walteraguirre/QCM/Circuitos - PCBs/Circuitos - PCBs/oscilador/osc_imp_fisica.pdf

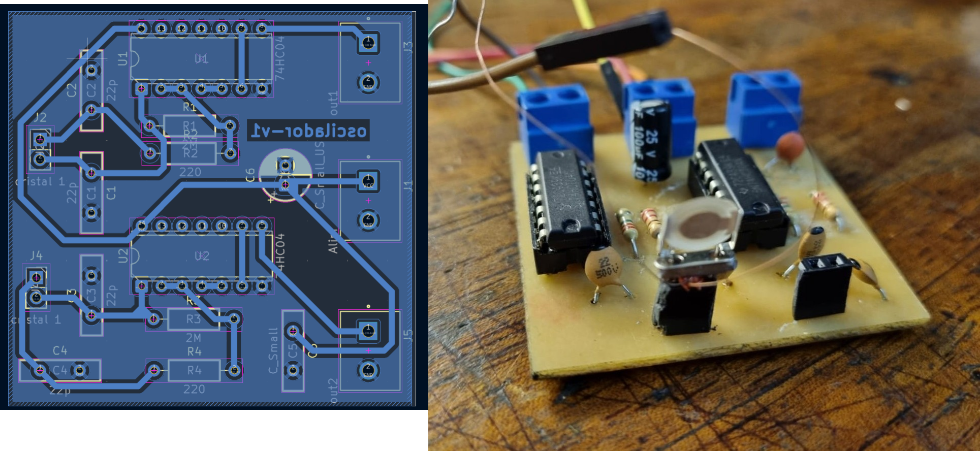
[picture p3: page 1]
