walteraguirre/QCM/Circuitos - PCBs/Circuitos - PCBs/oscilador_v2/pcb_abajo.png

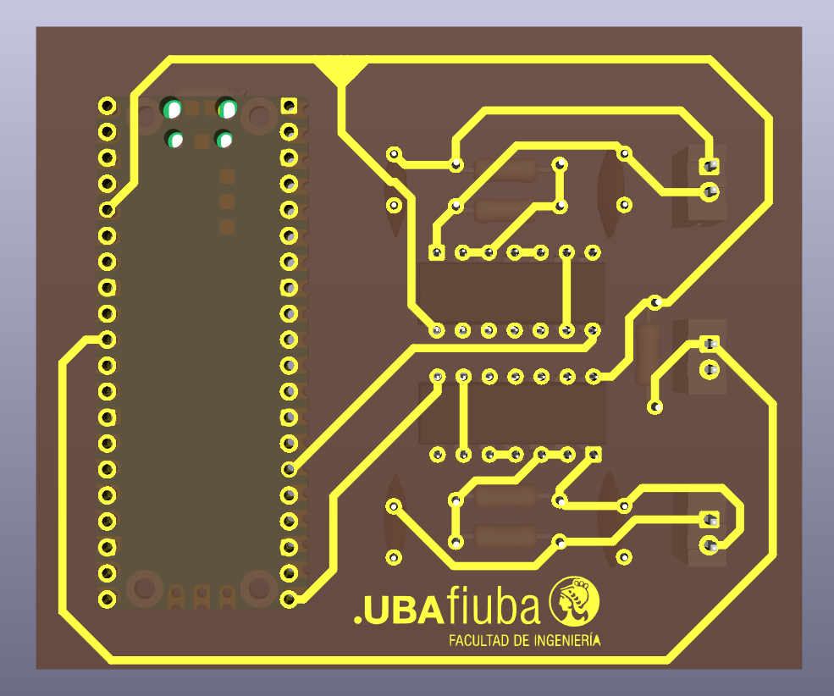
Circuitos - PCBs/Circuitos - PCBs/oscilador_v2/pcb_abajo.png
