walteraguirre/QCM/Circuitos - PCBs/Circuitos - PCBs/oscilador_v2/pcb_frente.png

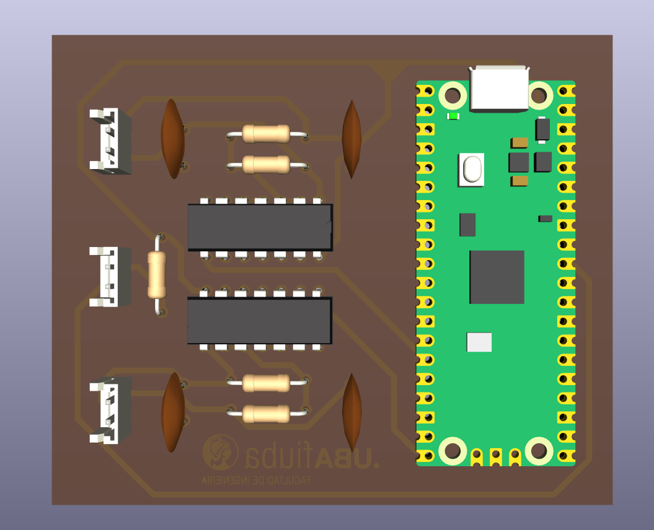
Circuitos - PCBs/Circuitos - PCBs/oscilador_v2/pcb_frente.png
