walteraguirre/QCM/error.png

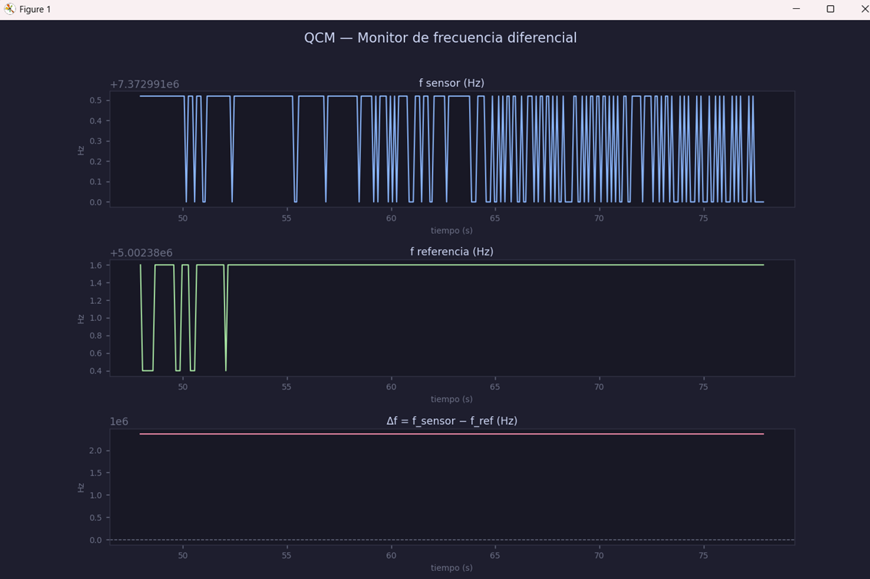
error.png
