walteraguirre/QCM/Gráficos/Oscilador/esquematico_oscilador_lt.png

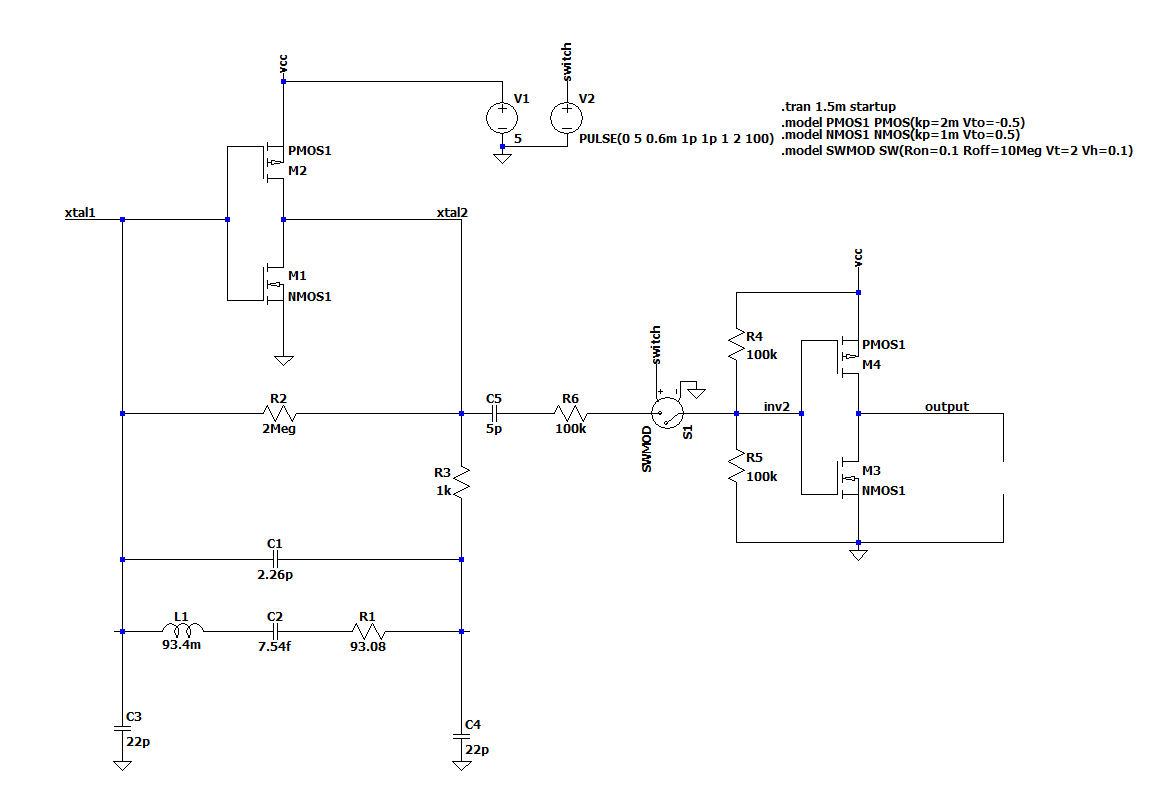
Gráficos/Oscilador/esquematico_oscilador_lt.png
