walteraguirre/QCM/Gráficos/Oscilador/medición_con_arduino_nano.jpeg

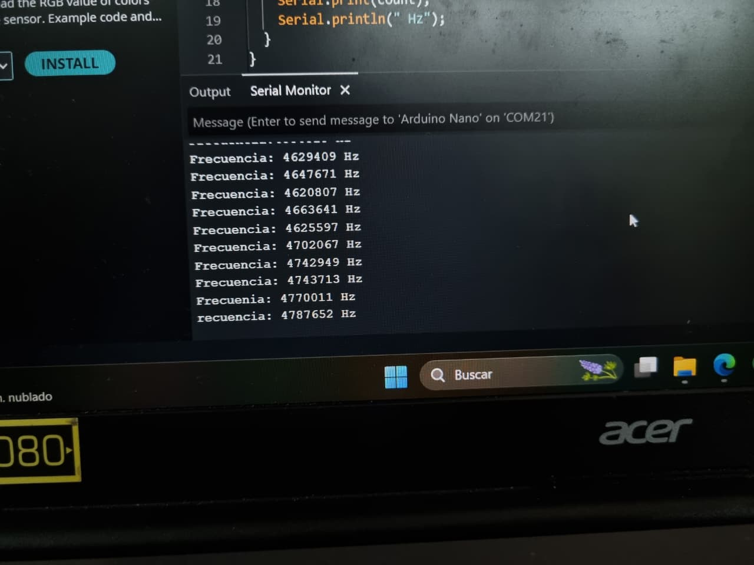
Gráficos/Oscilador/medición_con_arduino_nano.jpeg
