walteraguirre/QCM/Gráficos/Oscilador/osc_a_la_salida_del_buffer.jpeg

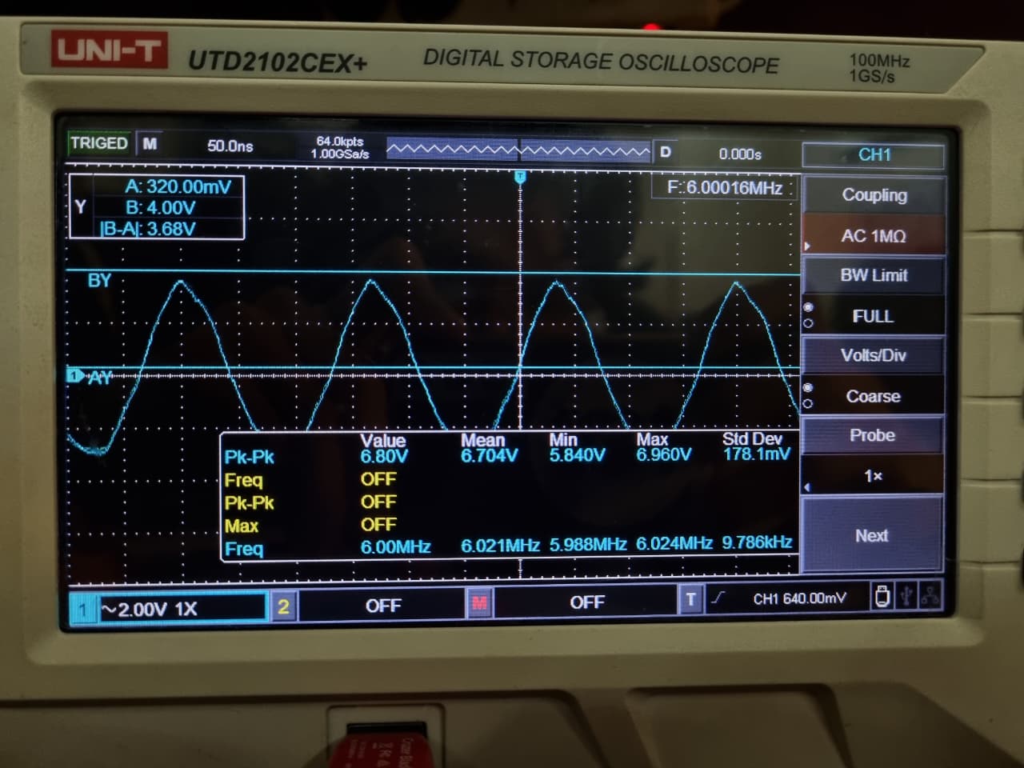
Gráficos/Oscilador/osc_a_la_salida_del_buffer.jpeg
