walteraguirre/QCM/Gráficos/Oscilador/osc_salida_buffer.jpeg

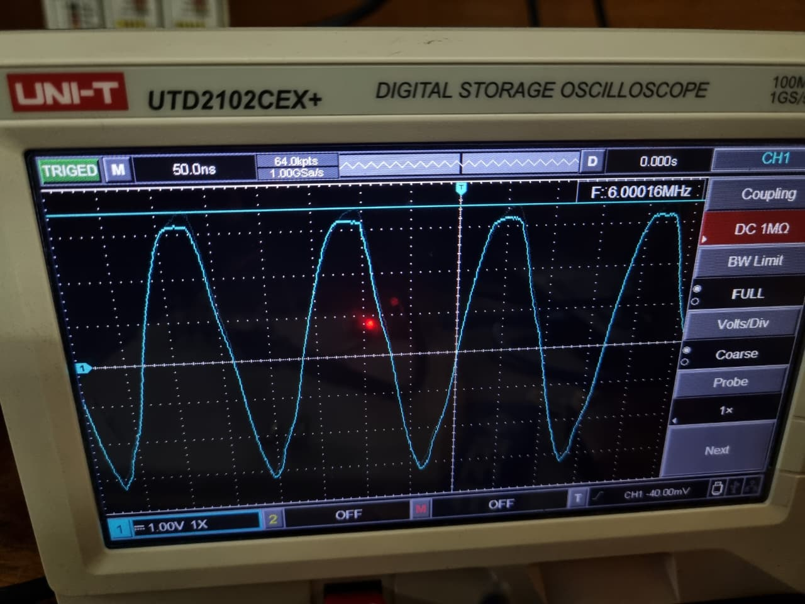
Gráficos/Oscilador/osc_salida_buffer.jpeg
