walteraguirre/QCM/Gráficos/Oscilador/osc_salida_cristal.jpeg

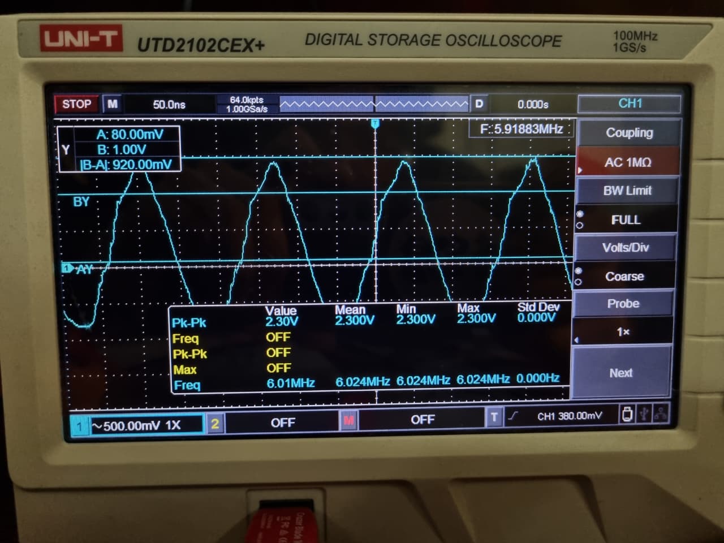
Gráficos/Oscilador/osc_salida_cristal.jpeg
