walteraguirre/QCM/Gráficos/Oscilador/osc_sin_buffer.png

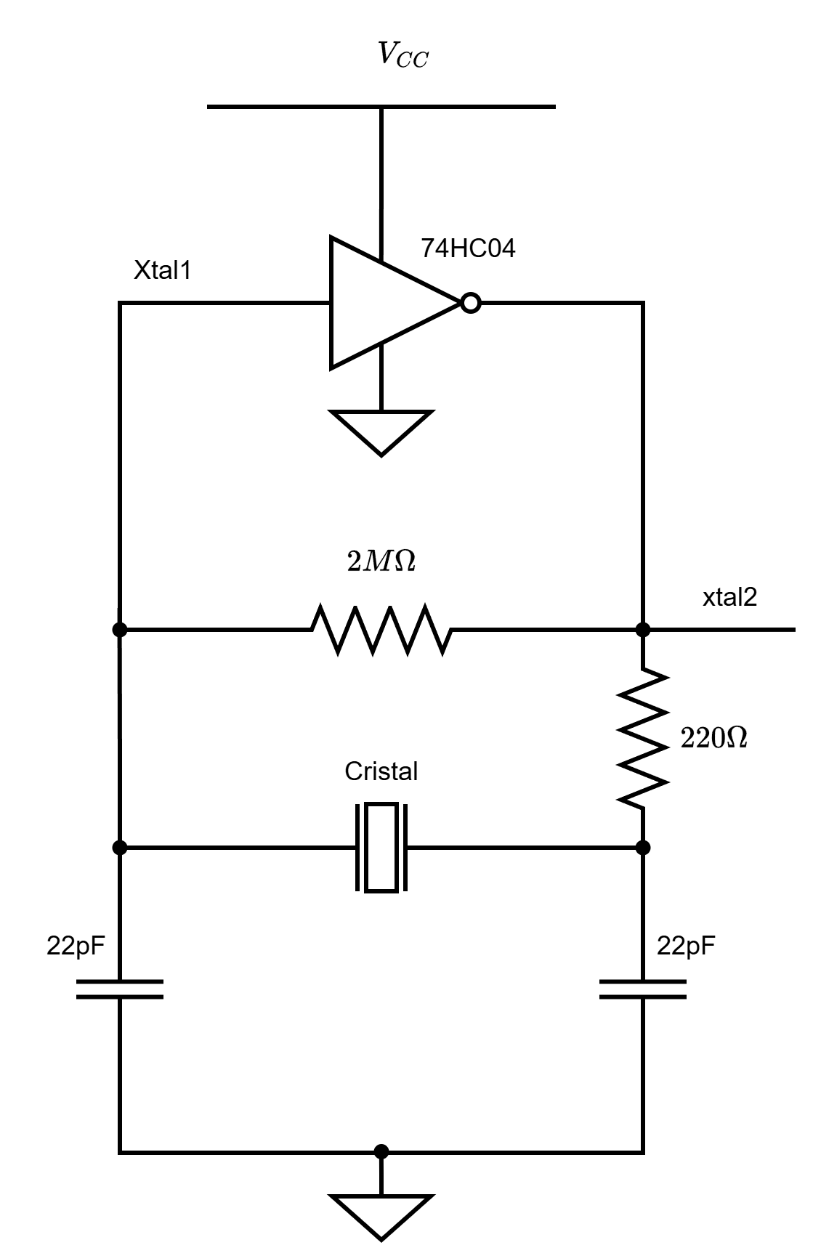
Gráficos/Oscilador/osc_sin_buffer.png
