walteraguirre/QCM/Gráficos/Oscilador/WhatsApp Image 2026-05-27 at 22.09.08.jpeg

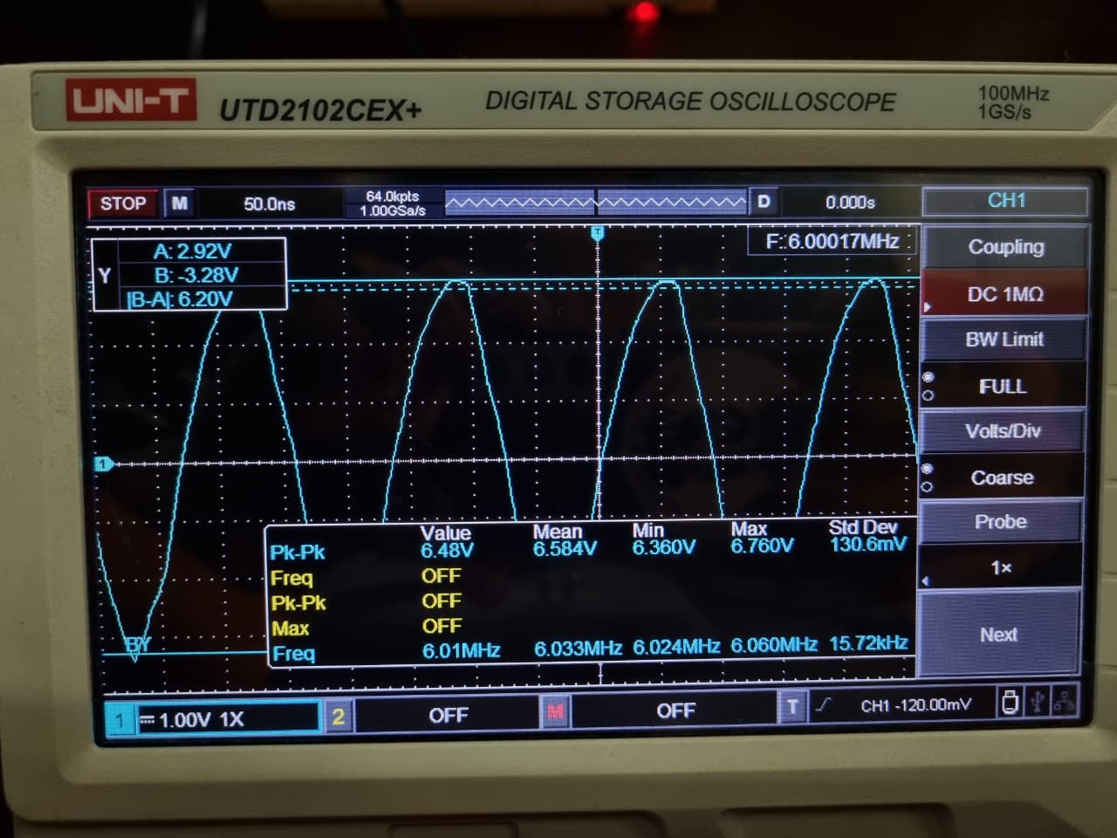
Gráficos/Oscilador/WhatsApp Image 2026-05-27 at 22.09.08.jpeg
