walteraguirre/QCM/pcb_osc.png

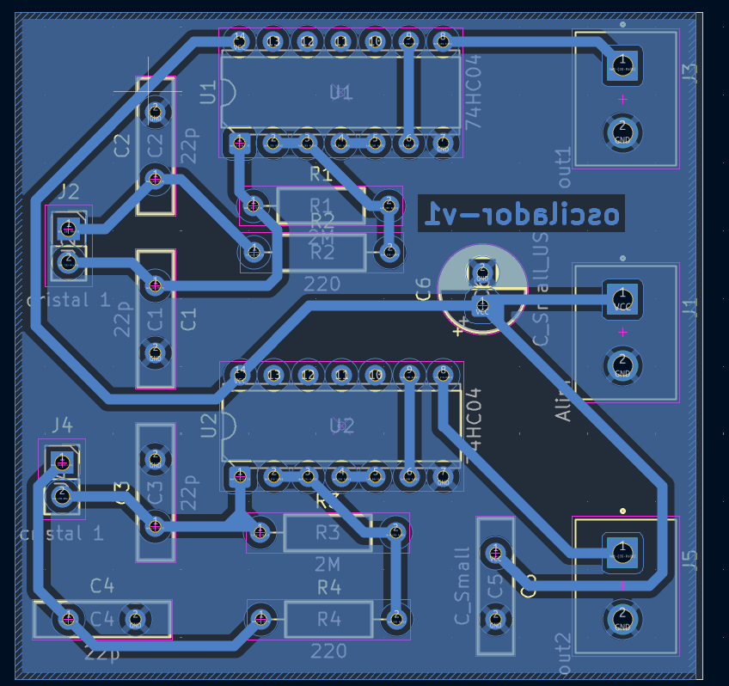
pcb_osc.png
