walteraguirre/QCM/Códigos/PC/Visualizador v1/prueba_termistor.csv

# QCM — 2026-10-13 11:40:28
# f0_real=7146438.762 Hz
# material_density=2700.0 kg/m3
# mode=single
timestamp_s | f_sensor_hz | f_ref_hz | delta_f_hz | espesor_nm | temp_c
31.0 | 7146437.600 | 7146438.762 | -1.162 | 0.037220 | 23.15
32.0 | 7146438.000 | 7146438.762 | -0.762 | 0.024408 | 21.32
33.0 | 7146440.000 | 7146438.762 | 1.238 | -0.039655 | 21.64
34.0 | 7146438.000 | 7146438.762 | -0.762 | 0.024408 | 21.07
35.0 | 7146438.400 | 7146438.762 | -0.362 | 0.011595 | 20.75
36.0 | 7146438.400 | 7146438.762 | -0.362 | 0.011595 | 20.84
37.0 | 7146436.000 | 7146438.762 | -2.762 | 0.088471 | 21.68
38.0 | 7146433.000 | 7146438.762 | -5.762 | 0.184565 | 20.93
39.0 | 7146431.000 | 7146438.762 | -7.762 | 0.248628 | 21.08
40.0 | 7146429.000 | 7146438.762 | -9.762 | 0.312691 | 21.34
41.0 | 7146426.000 | 7146438.762 | -12.762 | 0.408785 | 21.51
42.0 | 7146423.840 | 7146438.762 | -14.922 | 0.477973 | 20.80
43.0 | 7146422.000 | 7146438.762 | -16.762 | 0.536910 | 23.19
44.0 | 7146421.000 | 7146438.762 | -17.762 | 0.568942 | 21.73
45.0 | 7146420.000 | 7146438.762 | -18.762 | 0.600973 | 21.62
46.0 | 7146420.160 | 7146438.762 | -18.602 | 0.595848 | 20.93
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
