walteraguirre/QCM/Gráficos/Experimento con alcohol/mediciones/estabilidad_1.csv

# QCM — 2026-09-07 16:26:28
# f0_real=7149134.187 Hz
# material_density=2700.0 kg/m3
# mode=single
timestamp_s | f_sensor_hz | f_ref_hz | delta_f_hz | espesor_nm
31.0 | 7149133.600 | 7149134.187 | -0.587 | 0.018778
32.0 | 7149133.600 | 7149134.187 | -0.587 | 0.018778
33.0 | 7149133.600 | 7149134.187 | -0.587 | 0.018778
34.0 | 7149133.600 | 7149134.187 | -0.587 | 0.018778
35.0 | 7149133.600 | 7149134.187 | -0.587 | 0.018778
36.0 | 7149133.600 | 7149134.187 | -0.587 | 0.018778
37.0 | 7149133.000 | 7149134.187 | -1.187 | 0.037982
38.0 | 7149133.000 | 7149134.187 | -1.187 | 0.037982
39.0 | 7149133.000 | 7149134.187 | -1.187 | 0.037982
40.0 | 7149133.000 | 7149134.187 | -1.187 | 0.037982
41.0 | 7149133.000 | 7149134.187 | -1.187 | 0.037982
42.0 | 7149133.000 | 7149134.187 | -1.187 | 0.037982
43.0 | 7149133.000 | 7149134.187 | -1.187 | 0.037982
44.0 | 7149133.000 | 7149134.187 | -1.187 | 0.037982
45.0 | 7149133.000 | 7149134.187 | -1.187 | 0.037982
46.0 | 7149133.000 | 7149134.187 | -1.187 | 0.037982
47.0 | 7149133.000 | 7149134.187 | -1.187 | 0.037982
48.0 | 7149133.000 | 7149134.187 | -1.187 | 0.037982
49.0 | 7149133.000 | 7149134.187 | -1.187 | 0.037982
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
