walteraguirre/QCM/Gráficos/Experimento con alcohol/mediciones/estabilidad_30.csv

# QCM — 2026-09-08 17:28:47
# f0_real=7148857.376 Hz
# material_density=2700.0 kg/m3
# mode=single
timestamp_s | f_sensor_hz | f_ref_hz | delta_f_hz | espesor_nm
31.0 | 7148859.520 | 7148857.376 | 2.144 | -0.068629
32.0 | 7148859.000 | 7148857.376 | 1.624 | -0.051984
33.0 | 7148859.520 | 7148857.376 | 2.144 | -0.068629
34.0 | 7148860.000 | 7148857.376 | 2.624 | -0.083994
35.0 | 7148861.600 | 7148857.376 | 4.224 | -0.135209
36.0 | 7148863.000 | 7148857.376 | 5.624 | -0.180023
37.0 | 7148863.520 | 7148857.376 | 6.144 | -0.196668
38.0 | 7148863.520 | 7148857.376 | 6.144 | -0.196668
39.0 | 7148863.520 | 7148857.376 | 6.144 | -0.196668
40.0 | 7148863.520 | 7148857.376 | 6.144 | -0.196668
41.0 | 7148863.520 | 7148857.376 | 6.144 | -0.196668
42.0 | 7148863.000 | 7148857.376 | 5.624 | -0.180023
43.0 | 7148863.000 | 7148857.376 | 5.624 | -0.180023
44.0 | 7148862.400 | 7148857.376 | 5.024 | -0.160817
45.0 | 7148862.000 | 7148857.376 | 4.624 | -0.148013
46.0 | 7148862.400 | 7148857.376 | 5.024 | -0.160817
47.0 | 7148862.400 | 7148857.376 | 5.024 | -0.160817
48.0 | 7148863.000 | 7148857.376 | 5.624 | -0.180023
49.0 | 7148864.000 | 7148857.376 | 6.624 | -0.212032
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
