walteraguirre/QCM/Gráficos/Experimento con alcohol/mediciones/estabilidad_cristal_interno_rp.csv

# QCM — 2026-09-16 20:03:49
# f0_real=7150042.293 Hz
# material_density=2700.0 kg/m3
# mode=single
timestamp_s | f_sensor_hz | f_ref_hz | delta_f_hz | espesor_nm
193.0 | 7150042.000 | 7150042.293 | -0.293 | 0.009386
194.0 | 7150042.000 | 7150042.293 | -0.293 | 0.009386
195.0 | 7150042.000 | 7150042.293 | -0.293 | 0.009386
196.0 | 7150042.000 | 7150042.293 | -0.293 | 0.009386
197.0 | 7150042.000 | 7150042.293 | -0.293 | 0.009386
198.0 | 7150042.000 | 7150042.293 | -0.293 | 0.009386
199.0 | 7150042.000 | 7150042.293 | -0.293 | 0.009386
200.0 | 7150042.000 | 7150042.293 | -0.293 | 0.009386
201.0 | 7150042.000 | 7150042.293 | -0.293 | 0.009386
202.0 | 7150042.000 | 7150042.293 | -0.293 | 0.009386
203.0 | 7150042.000 | 7150042.293 | -0.293 | 0.009386
204.0 | 7150042.000 | 7150042.293 | -0.293 | 0.009386
205.0 | 7150042.000 | 7150042.293 | -0.293 | 0.009386
206.0 | 7150042.000 | 7150042.293 | -0.293 | 0.009386
207.0 | 7150042.000 | 7150042.293 | -0.293 | 0.009386
208.0 | 7150042.000 | 7150042.293 | -0.293 | 0.009386
209.0 | 7150042.000 | 7150042.293 | -0.293 | 0.009386
210.0 | 7150042.000 | 7150042.293 | -0.293 | 0.009386
211.0 | 7150042.000 | 7150042.293 | -0.293 | 0.009386
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
