walteraguirre/QCM/Gráficos/Experimento con alcohol/mediciones/etanol_00.csv

# QCM — 2026-09-03 19:00:15
# f0_real=7149073.600 Hz
# densidad_material=2700.0 kg/m3
# modo=single
timestamp_s | f_sensor_hz | f_ref_hz | delta_f_hz | espesor_nm
5.0 | 7149073.000 | 7149073.600 | -0.600 | 0.019205
6.0 | 7149072.000 | 7149073.600 | -1.600 | 0.051212
7.0 | 7149071.520 | 7149073.600 | -2.080 | 0.066576
8.0 | 7149069.000 | 7149073.600 | -4.600 | 0.147236
9.0 | 7149067.840 | 7149073.600 | -5.760 | 0.184365
10.0 | 7149068.000 | 7149073.600 | -5.600 | 0.179244
11.0 | 7149068.000 | 7149073.600 | -5.600 | 0.179244
12.0 | 7149066.000 | 7149073.600 | -7.600 | 0.243259
13.0 | 7149065.600 | 7149073.600 | -8.000 | 0.256062
14.0 | 7149065.000 | 7149073.600 | -8.600 | 0.275267
15.0 | 7149064.000 | 7149073.600 | -9.600 | 0.307275
16.0 | 7149065.600 | 7149073.600 | -8.000 | 0.256062
17.0 | 7149068.000 | 7149073.600 | -5.600 | 0.179244
18.0 | 7149066.000 | 7149073.600 | -7.600 | 0.243259
19.0 | 7149064.160 | 7149073.600 | -9.440 | 0.302154
20.0 | 7149064.160 | 7149073.600 | -9.440 | 0.302154
21.0 | 7149065.000 | 7149073.600 | -8.600 | 0.275267
22.0 | 7149066.000 | 7149073.600 | -7.600 | 0.243259
23.0 | 7149065.600 | 7149073.600 | -8.000 | 0.256062
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
