walteraguirre/QCM/Gráficos/Experimento con alcohol/mediciones/medicion_aislado_01.csv

# QCM — 2026-09-14 21:32:25
# f0_real=7152504.000 Hz
# material_density=2700.0 kg/m3
# mode=single
timestamp_s | f_sensor_hz | f_ref_hz | delta_f_hz | espesor_nm
31.0 | 7152504.160 | 7152504.000 | 0.160 | -0.005116
32.0 | 7152504.000 | 7152504.000 | 0.000 | -0.000000
33.0 | 7152504.160 | 7152504.000 | 0.160 | -0.005116
34.0 | 7152504.000 | 7152504.000 | 0.000 | -0.000000
35.0 | 7152504.000 | 7152504.000 | 0.000 | -0.000000
36.0 | 7152504.000 | 7152504.000 | 0.000 | -0.000000
37.0 | 7152504.000 | 7152504.000 | 0.000 | -0.000000
38.0 | 7152504.000 | 7152504.000 | 0.000 | -0.000000
39.0 | 7152504.000 | 7152504.000 | 0.000 | -0.000000
40.0 | 7152504.000 | 7152504.000 | 0.000 | -0.000000
41.0 | 7152504.000 | 7152504.000 | 0.000 | -0.000000
42.0 | 7152504.000 | 7152504.000 | 0.000 | -0.000000
43.0 | 7152504.160 | 7152504.000 | 0.160 | -0.005116
44.0 | 7152504.160 | 7152504.000 | 0.160 | -0.005116
45.0 | 7152504.000 | 7152504.000 | 0.000 | -0.000000
46.0 | 7152504.160 | 7152504.000 | 0.160 | -0.005116
47.0 | 7152504.000 | 7152504.000 | 0.000 | -0.000000
48.0 | 7152504.000 | 7152504.000 | 0.000 | -0.000000
49.0 | 7152504.160 | 7152504.000 | 0.160 | -0.005116
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
