walteraguirre/QCM/Códigos/Raspberry/reciprocal_frec_counter/resultados1.png

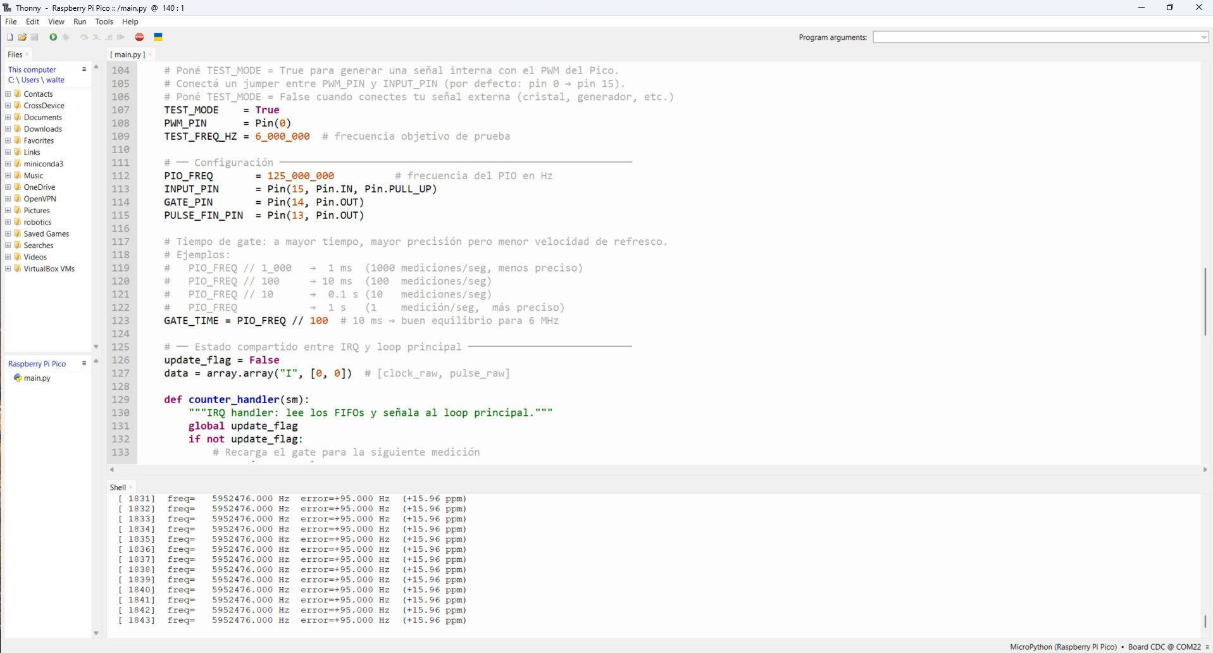
Códigos/Raspberry/reciprocal_frec_counter/resultados1.png
