walteraguirre/QCM/Códigos/Raspberry/reciprocal_frec_counter/resultados_gen_func.png

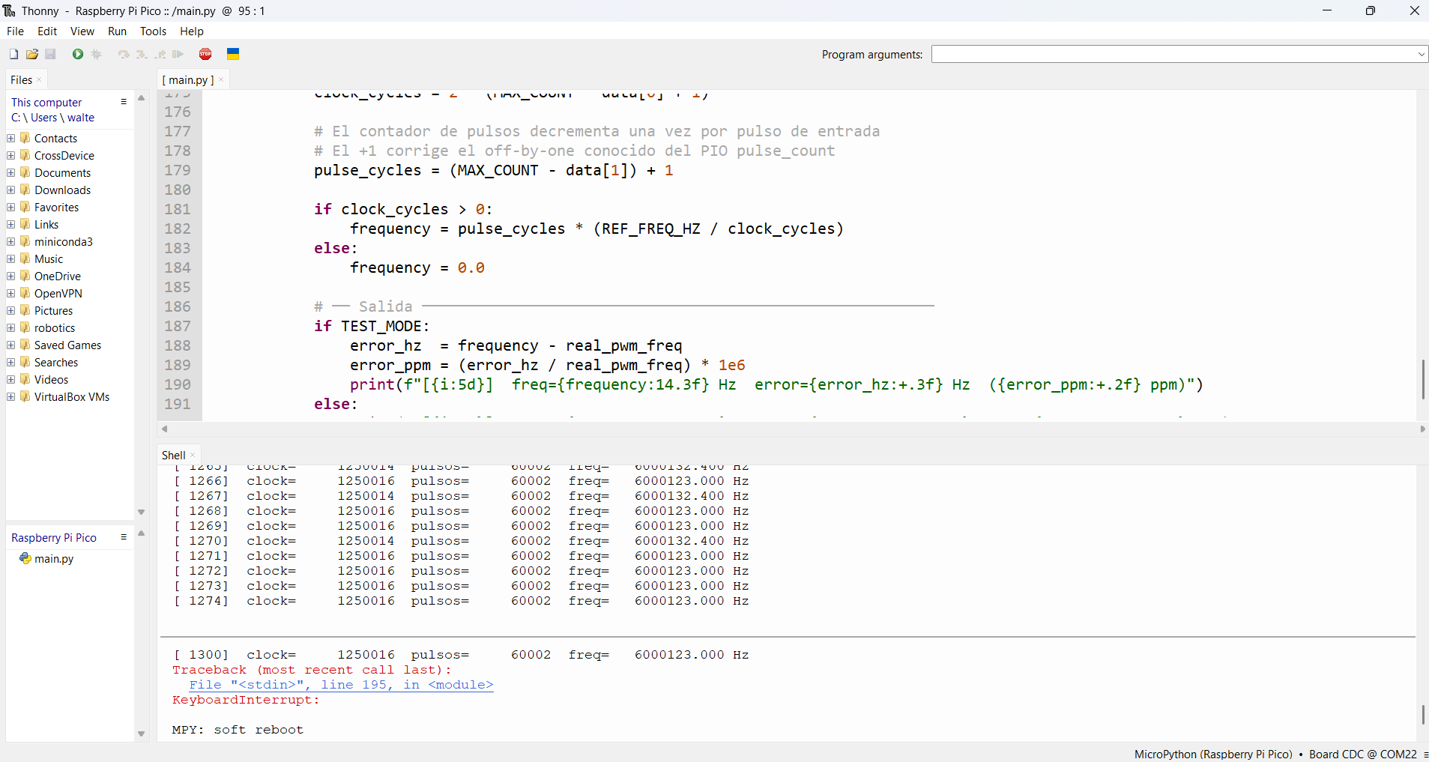
Códigos/Raspberry/reciprocal_frec_counter/resultados_gen_func.png
