walteraguirre/QCM/Gráficos/Experimento con alcohol/estado_estacionario.png

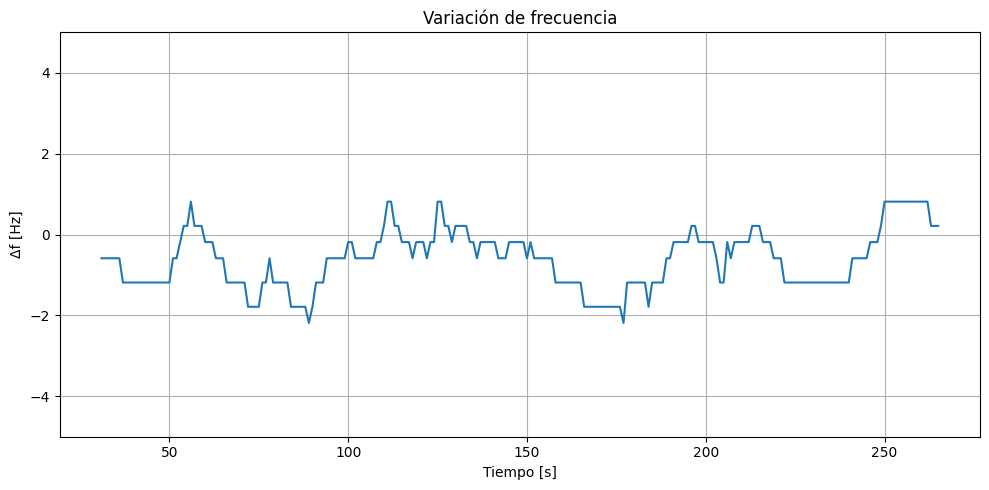
Gráficos/Experimento con alcohol/estado_estacionario.png
