walteraguirre/QCM/Circuitos - PCBs/Circuitos - PCBs/oscilador/esquemático.pdf

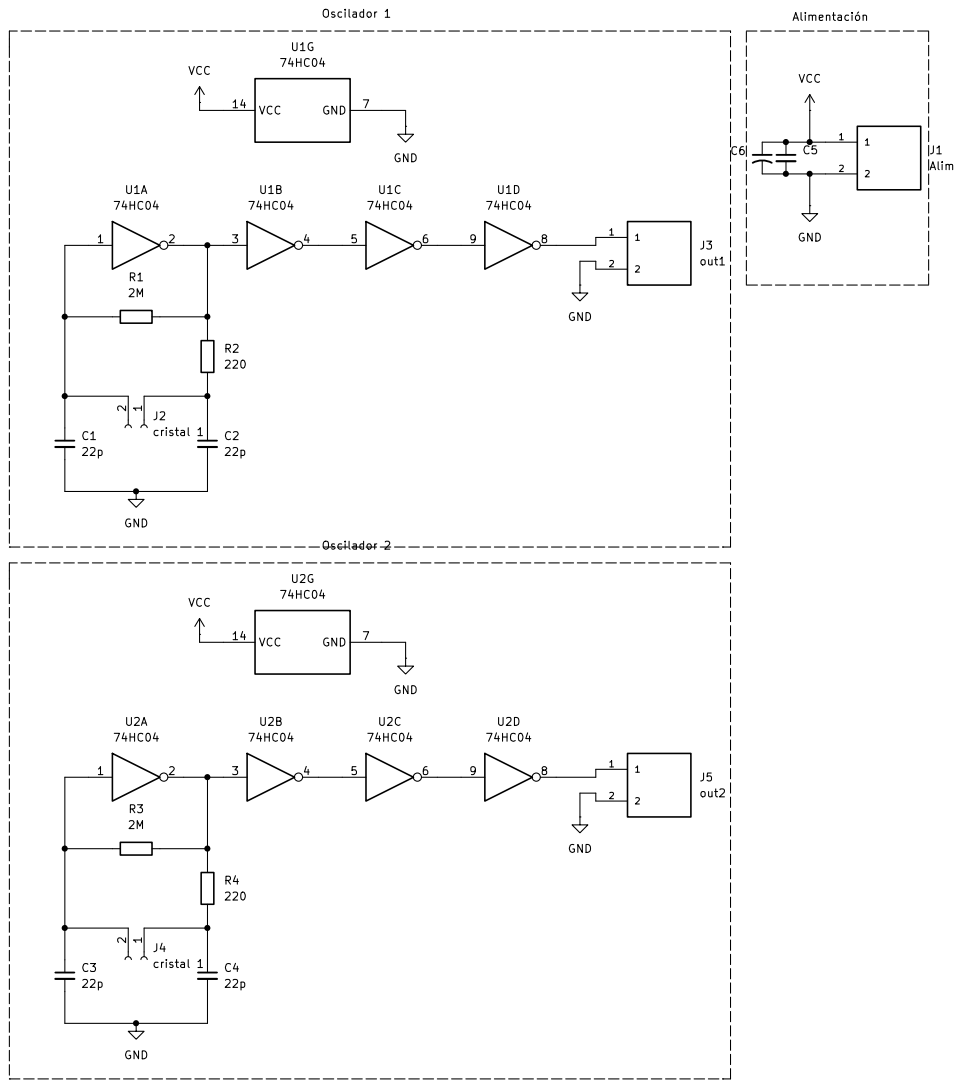
[picture p19: page 1]
