walteraguirre/QCM/Circuitos - PCBs/Circuitos - PCBs/oscilador_v2/esquemático.pdf

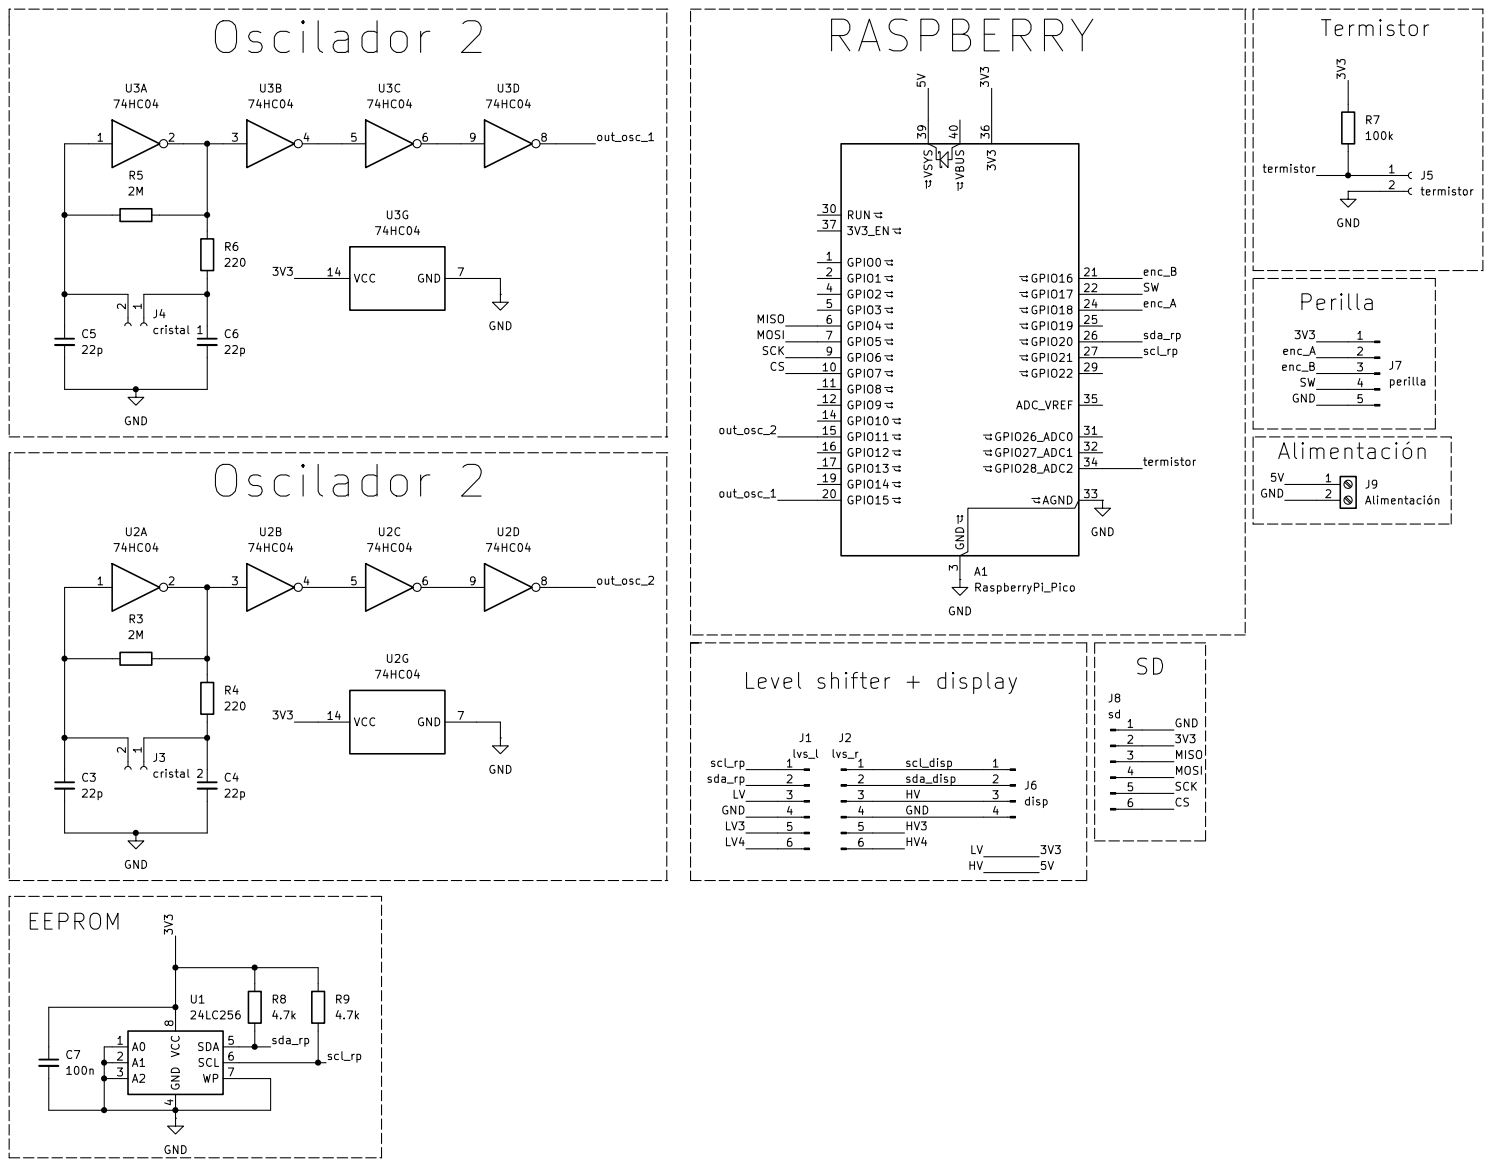
[picture p20: page 1]
