walteraguirre/QCM/Circuitos - PCBs/Circuitos - PCBs/oscilador_v2/pcb_qcm.pdf

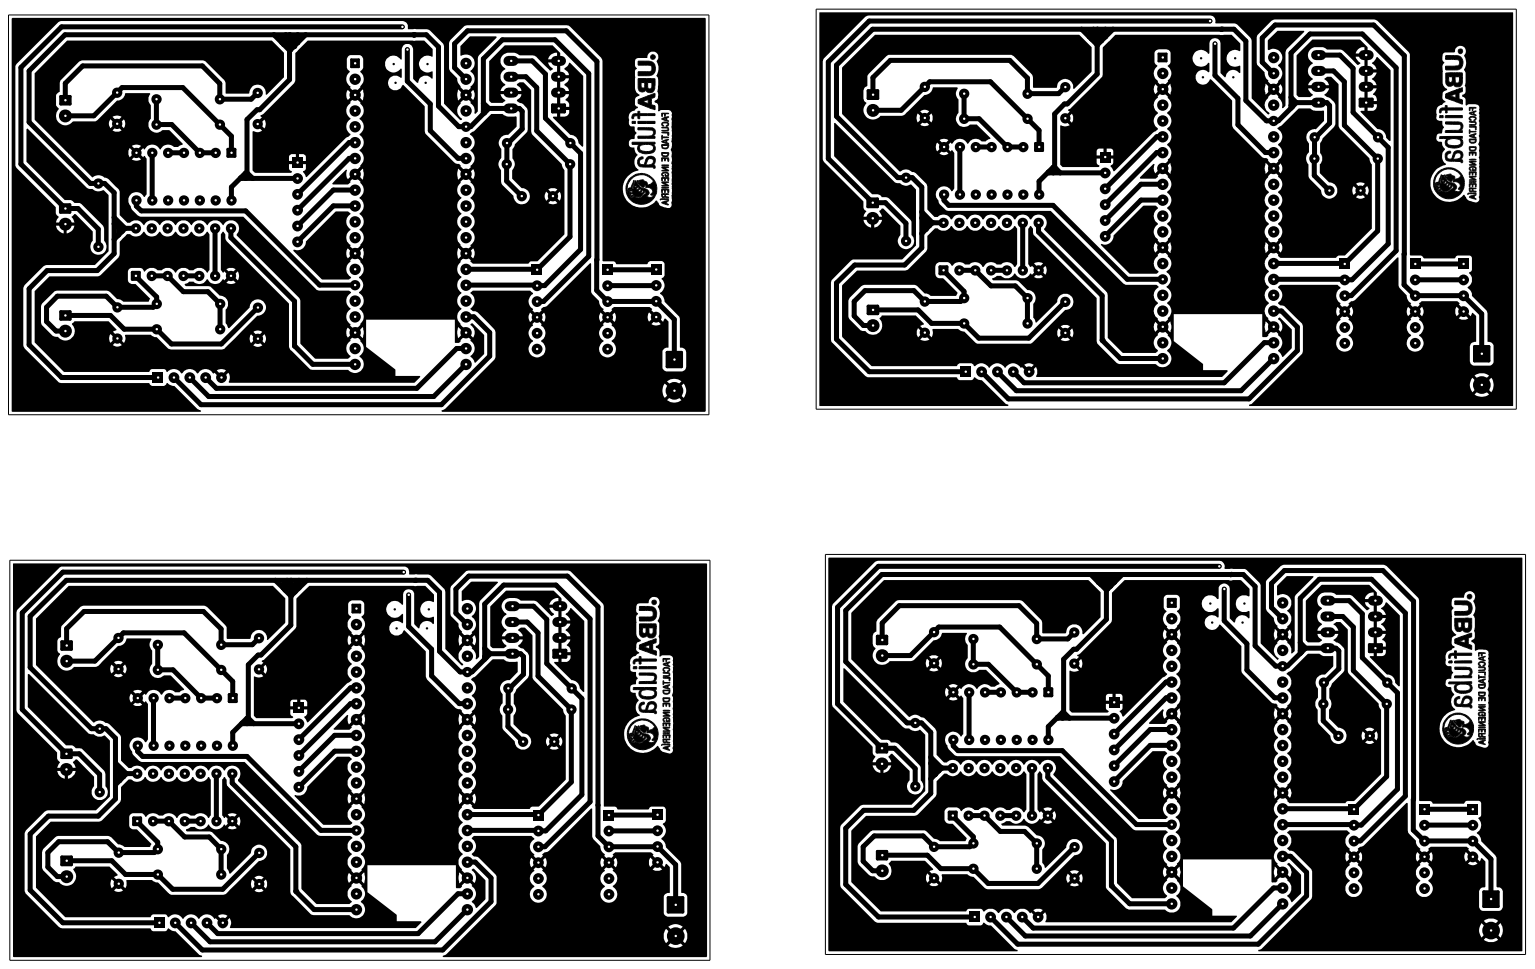
[picture p21: page 1]
