walteraguirre/QCM/Circuitos - PCBs/Circuitos - PCBs/oscilador/oscilador-B_Cu.pdf

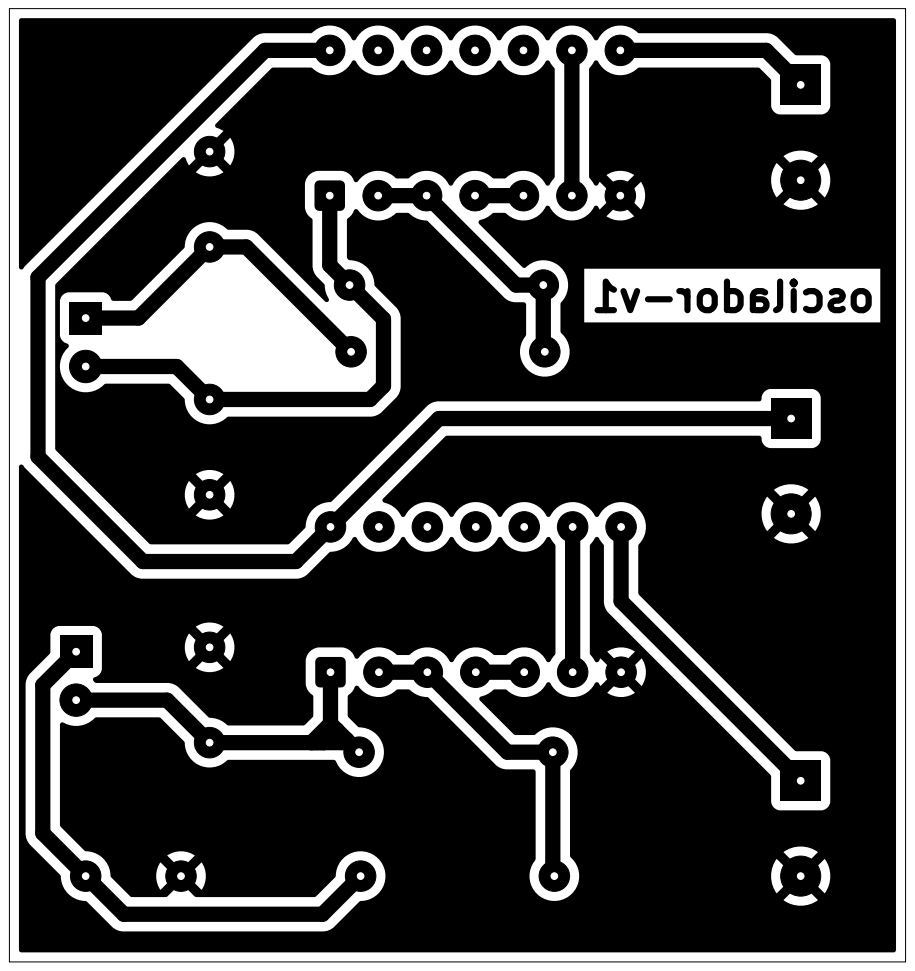
[picture p22: page 1]
