walteraguirre/QCM/Circuitos - PCBs/Circuitos - PCBs/oscilador/oscilador_pcb.pdf

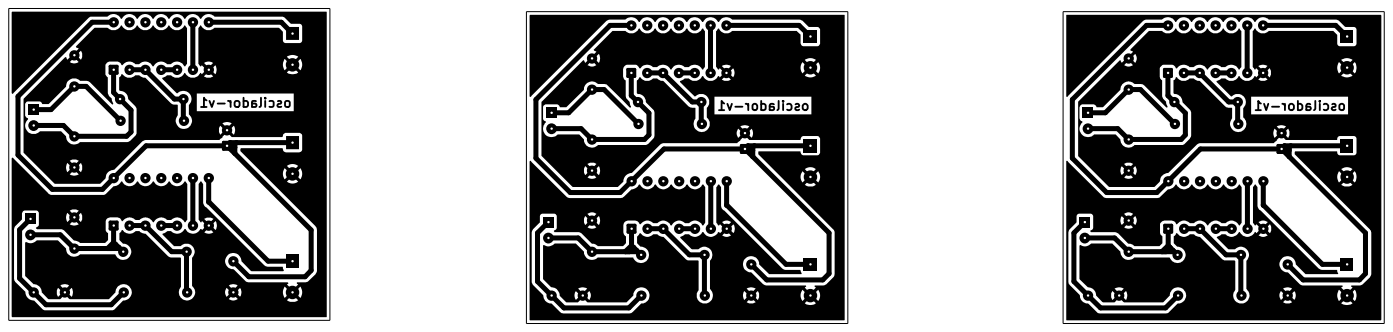
[picture p23: page 1]
