walteraguirre/QCM/Simulaciones/oscilador tesis wei/osc_hc04.asc

C1: cap; 2.26p
C2: cap; 7.54f
C3: cap; 22p
C4: cap; 22p
L1: ind; 93.4m; Rser=1m
R1: res; 93.08
R2: res; 470k
R3: res; 220
U1: inv; HCU04pck
U2: inv; HCU04pck
U3: inv; HCU04pck
U4: inv; HCU04pck
V1: voltage; 5
Named nets: 0, xtal1, xtal2, vcc, out
.tran 0 5m 0 10u startup
.include hc/hc_tnomi.cir
.include hc/dip.s
.options method=gear
.options reltol=0.01
