walteraguirre/QCM/Simulaciones/oscilador tesis wei/oscilador_unit1.asc

C1: cap; 2.26p
C2: cap; 7.54f
C3: cap; 22p
C4: cap; 22p
C5: cap; 5p
L1: ind; 93.4m; Rser=1m
M1: nmos; NMOS1
M2: pmos; PMOS1
M3: nmos; NMOS1
M4: pmos; PMOS1
R1: res; 93.08
R2: res; 2Meg
R3: res; 1k
R4: res; 100k
R5: res; 100k
R6: res; 100k
S1: sw; SWMOD
V1: voltage; 5
V2: voltage; PULSE(0 5 0.6m 1p 1p 1 2 100)
Named nets: 0, vcc, xtal1, xtal2, output, inv2, switch
.model PMOS1 PMOS(kp=2m Vto=-0.5)
.model NMOS1 NMOS(kp=1m Vto=0.5)
.tran 1.5m startup
.model SWMOD SW(Ron=0.1 Roff=10Meg Vt=2 Vh=0.1)
