walteraguirre/QCM/Circuitos - PCBs/Circuitos - PCBs/oscilador_v2/oscilador_v2.kicad_pcb

## KiCad design Circuitos - PCBs/Circuitos - PCBs/oscilador_v2/oscilador_v2.kicad_pcb (2026-10-15)

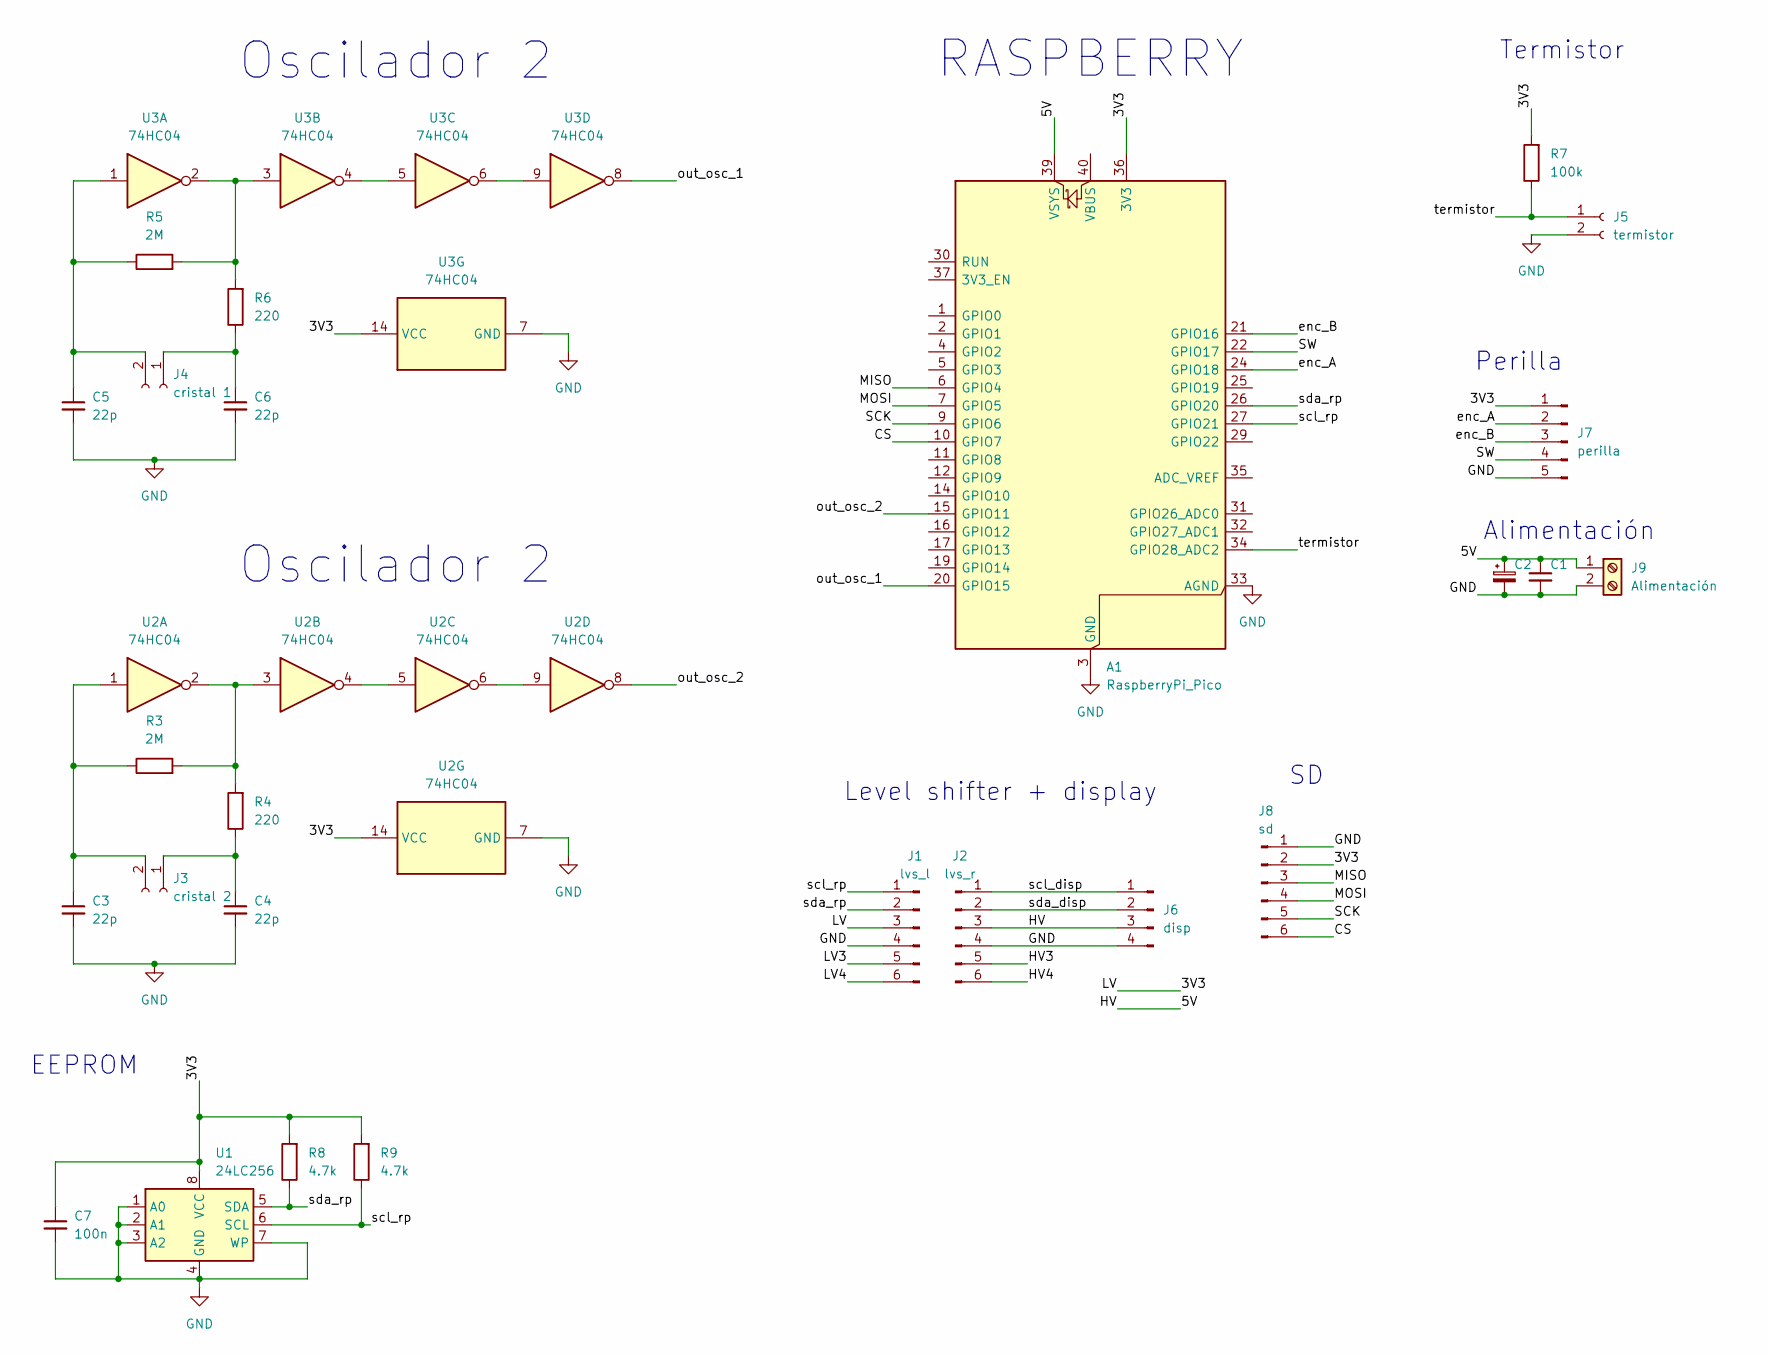
[picture p24: schematic oscilador_v2.kicad_sch]

Parts:
A1: RaspberryPi_Pico; RaspberryPi_Pico_Common_Unspecified
C1: C_Small; C_Disc_D10.0mm_W2.5mm_P5.00mm
C2: C_Polarized_Small; CP_Radial_D5.0mm_P2.50mm
C3, C4, C5, C6: 22p; C_Disc_D10.0mm_W2.5mm_P5.00mm
C7: 100n; C_Disc_D10.0mm_W2.5mm_P5.00mm
J1: lvs_l; PinSocket_1x06_P2.54mm_Vertical
J2: lvs_r; PinSocket_1x06_P2.54mm_Vertical
J3: cristal 2; JST_EH_B2B-EH-A_1x02_P2.50mm_Vertical
J4: cristal 1; JST_EH_B2B-EH-A_1x02_P2.50mm_Vertical
J5: termistor; JST_EH_B2B-EH-A_1x02_P2.50mm_Vertical
J6: disp; PinHeader_1x04_P2.54mm_Vertical
J7: perilla; PinHeader_1x05_P2.54mm_Vertical
J8: sd; PinSocket_1x06_P2.54mm_Vertical
J9: Alimentación; TerminalBlock_MaiXu_MX126-5.0-02P_1x02_P5.00mm
R3, R5: 2M; R_Axial_DIN0207_L6.3mm_D2.5mm_P10.16mm_Horizontal
R4, R6: 220; R_Axial_DIN0207_L6.3mm_D2.5mm_P10.16mm_Horizontal
R7: 100k; R_Axial_DIN0207_L6.3mm_D2.5mm_P10.16mm_Horizontal
R8, R9: 4.7k; R_Axial_DIN0207_L6.3mm_D2.5mm_P10.16mm_Horizontal
U1: 24LC256; DIP-8_W7.62mm_LongPads
U2, U3: 74HC04; DIP-14_W7.62mm

Connections:
/3V3: A1.36 (3V3), C7.1, J1.3, J7.1, J8.2, R7.2, R8.2, R9.2, U1.8 (VCC), U2.14 (VCC), U3.14 (VCC)
/5V: A1.39 (VSYS), C1.1, C2.1, J2.3, J6.3, J9.1
/CS: A1.10 (GPIO7), J8.6
/HV3: J2.5
/HV4: J2.6
/LV3: J1.5
/LV4: J1.6
/MISO: A1.6 (GPIO4), J8.3
/MOSI: A1.7 (GPIO5), J8.4
/SCK: A1.9 (GPIO6), J8.5
/SW: A1.22 (GPIO17), J7.4
/enc_A: A1.24 (GPIO18), J7.2
/enc_B: A1.21 (GPIO16), J7.3
/out_osc_1: A1.20 (GPIO15), U3.8
/out_osc_2: A1.15 (GPIO11), U2.8
/scl_disp: J2.1, J6.1
/scl_rp: A1.27 (GPIO21), J1.1, R9.1, U1.6 (SCL)
/sda_disp: J2.2, J6.2
/sda_rp: A1.26 (GPIO20), J1.2, R8.1, U1.5 (SDA)
/termistor: A1.34 (GPIO28_ADC2), J5.1, R7.1
GND: A1.3 (GND), A1.8 (GND), A1.13 (GND), A1.18 (GND), A1.23 (GND), A1.28 (GND), A1.33 (AGND), A1.38 (GND), C1.2, C2.2, C3.2, C4.2, C5.2, C6.2, C7.2, J1.4, J2.4, J5.2, J6.4, J7.5, J8.1, J9.2, U1.1 (A0), U1.2 (A1), U1.3 (A2), U1.4 (GND), U1.7 (WP), U2.7 (GND), U3.7 (GND)
unnamed: C4.1, J3.1, R4.1
unnamed: C3.1, J3.2, R3.1, U2.1
unnamed: C6.1, J4.1, R6.1
unnamed: C5.1, J4.2, R5.1, U3.1
unnamed: R3.2, R4.2, U2.2, U2.3
unnamed: R5.2, R6.2, U3.2, U3.3
unnamed: U2.4, U2.5
unnamed: U2.6, U2.9
unnamed: U3.4, U3.5
unnamed: U3.6, U3.9

Notes on the sheet:
Level shifter + display
Perilla
Alimentación
Oscilador 2
EEPROM
Termistor
RASPBERRY

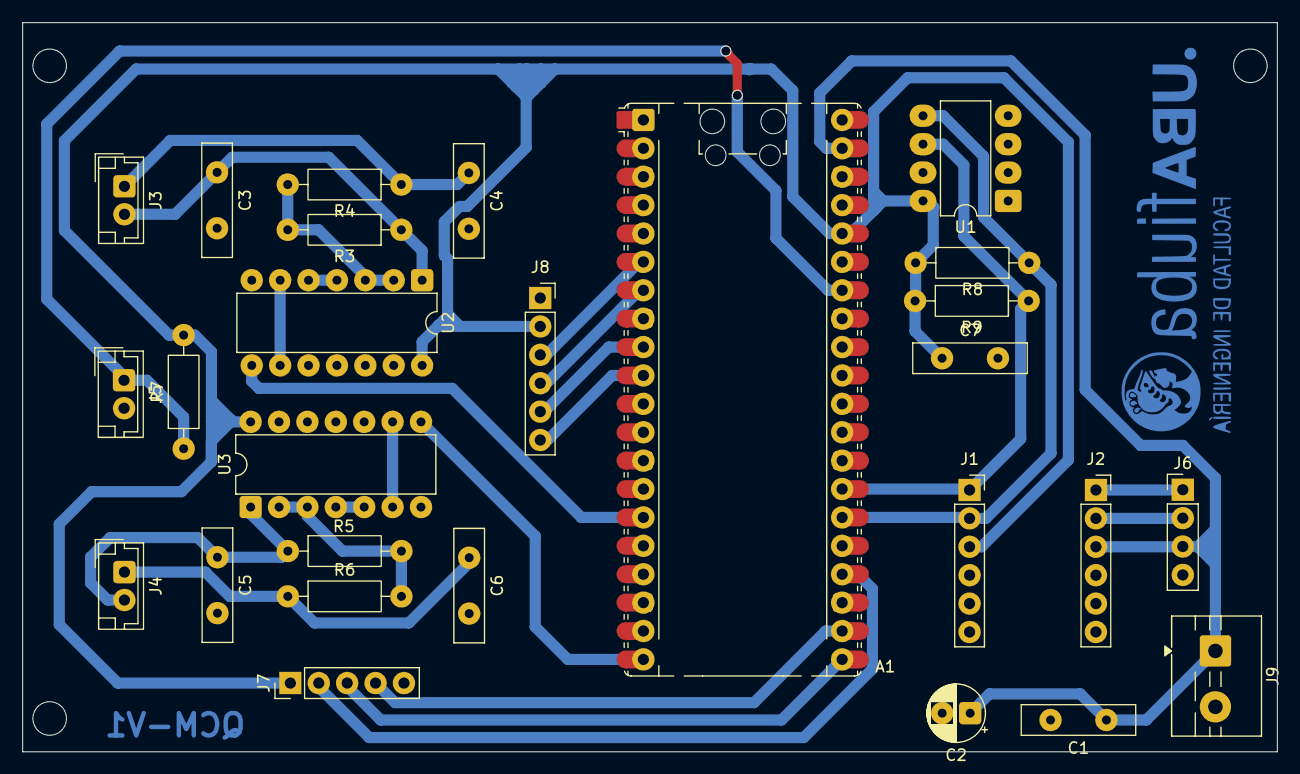
[picture p25: board oscilador_v2.kicad_pcb from above]

Board: 2 copper layers, 112.2 x 65.2 mm, 27 parts (0 on the bottom side), 27 nets.
