walteraguirre/QCM/Circuitos - PCBs/Circuitos - PCBs/oscilador/oscilador.kicad_pcb

## KiCad design Circuitos - PCBs/Circuitos - PCBs/oscilador/oscilador.kicad_pcb (2026-08-18)

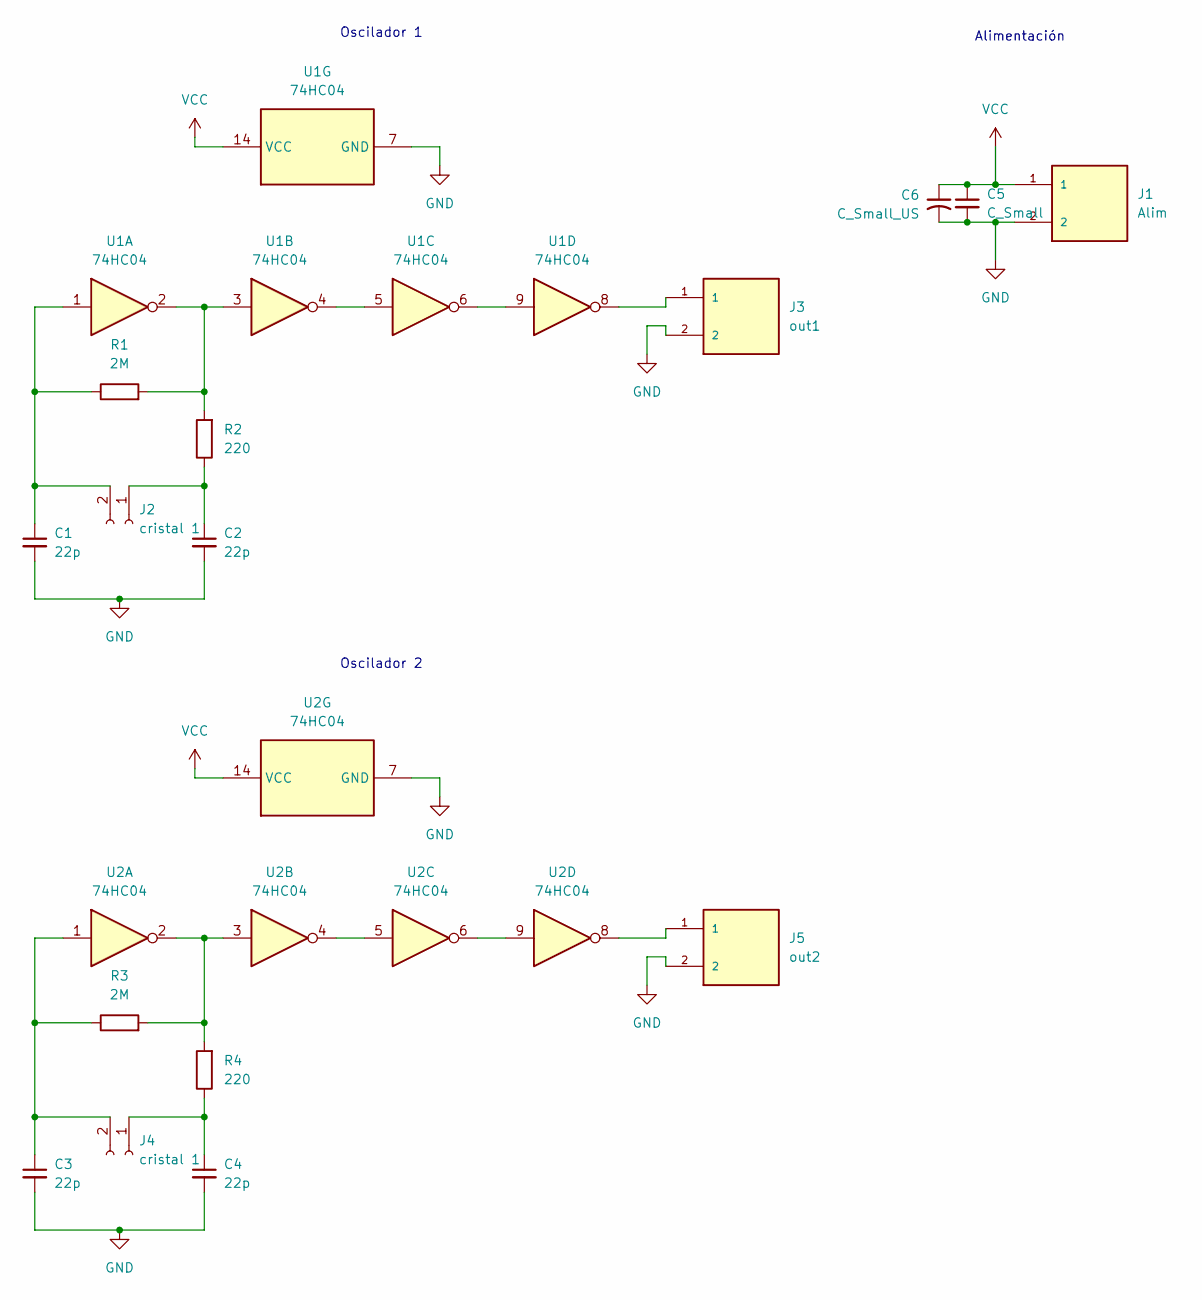
[picture p26: schematic oscilador.kicad_sch]

Parts:
C1, C2, C3, C4: 22p; C_Disc_D10.0mm_W2.5mm_P5.00mm
C5: C_Small; C_Disc_D10.0mm_W2.5mm_P5.00mm
C6: C_Small_US; CP_Radial_D6.3mm_P2.50mm
J1: Alim; HANDSON_KF301-2P; PARTREV NA
J2, J4: cristal 1; PinSocket_1x02_P2.54mm_Vertical
J3: out1; HANDSON_KF301-2P; PARTREV NA
J5: out2; HANDSON_KF301-2P; PARTREV NA
R1, R3: 2M; R_Axial_DIN0207_L6.3mm_D2.5mm_P10.16mm_Horizontal
R2, R4: 220; R_Axial_DIN0207_L6.3mm_D2.5mm_P10.16mm_Horizontal
U1, U2: 74HC04; DIP-14_W7.62mm

Connections:
GND: C1.2, C2.2, C3.2, C4.2, C5.2, C6.2, J1.2, J3.2, J5.2, U1.7 (GND), U2.7 (GND)
unnamed: C2.1, J2.1, R2.1
unnamed: C1.1, J2.2, R1.1, U1.1
unnamed: J3.1, U1.8
unnamed: C4.1, J4.1, R4.1
unnamed: C3.1, J4.2, R3.1, U2.1
unnamed: J5.1, U2.8
unnamed: R1.2, R2.2, U1.2, U1.3
unnamed: R3.2, R4.2, U2.2, U2.3
unnamed: U1.4, U1.5
unnamed: U1.6, U1.9
unnamed: U2.4, U2.5
unnamed: U2.6, U2.9
VCC: C5.1, C6.1, J1.1, U1.14 (VCC), U2.14 (VCC)

Notes on the sheet:
Oscilador 1
Oscilador 2
Alimentación

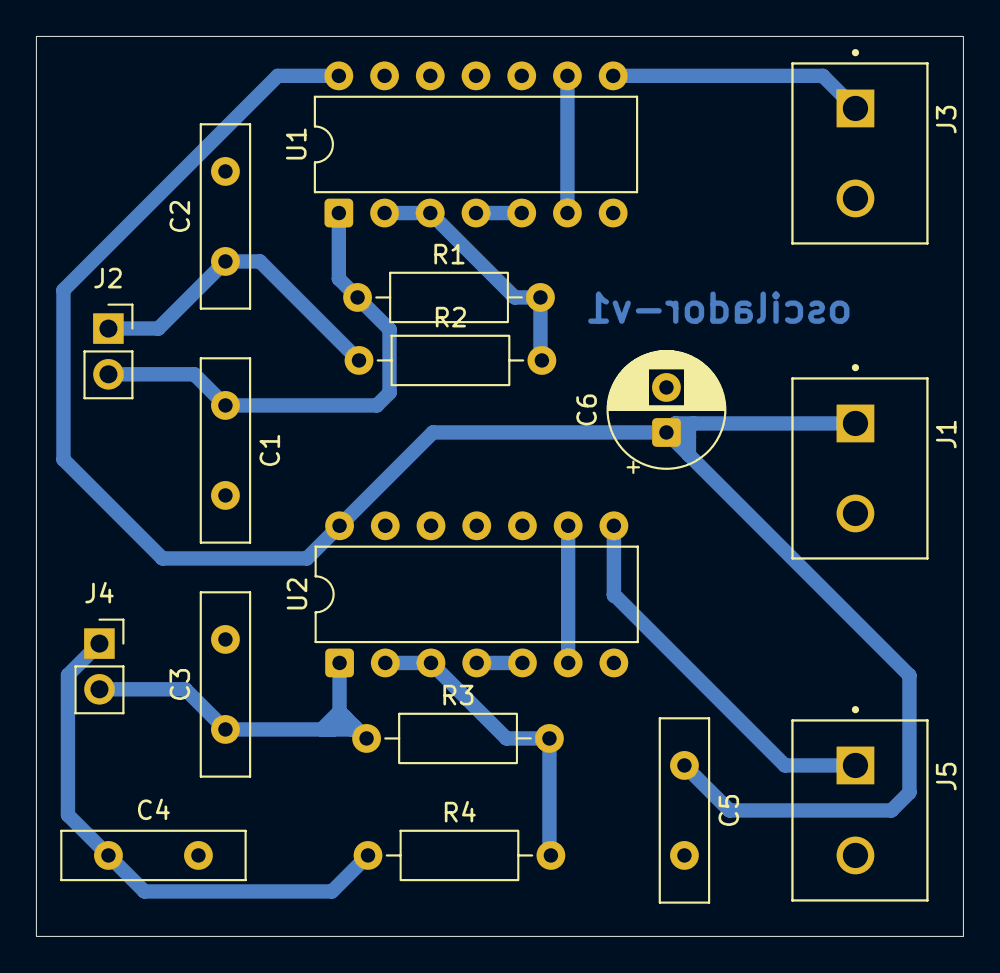
[picture p27: board oscilador.kicad_pcb from above]

Board: 2 copper layers, 51.5 x 50.0 mm, 17 parts (0 on the bottom side), 14 nets.
