walteraguirre/QCM/(commit log)

2026-08-18 Primer commit, ya contiene códigos para la raspberry, pcbs y lecturas adicionales
2026-08-18 ya probé los códigos para la GUI
2026-10-29 Actualiza mediciones y analisis de caracterizacion del cristal
